Johnlon/integrated-circuit-tester/exploratoryTool.png

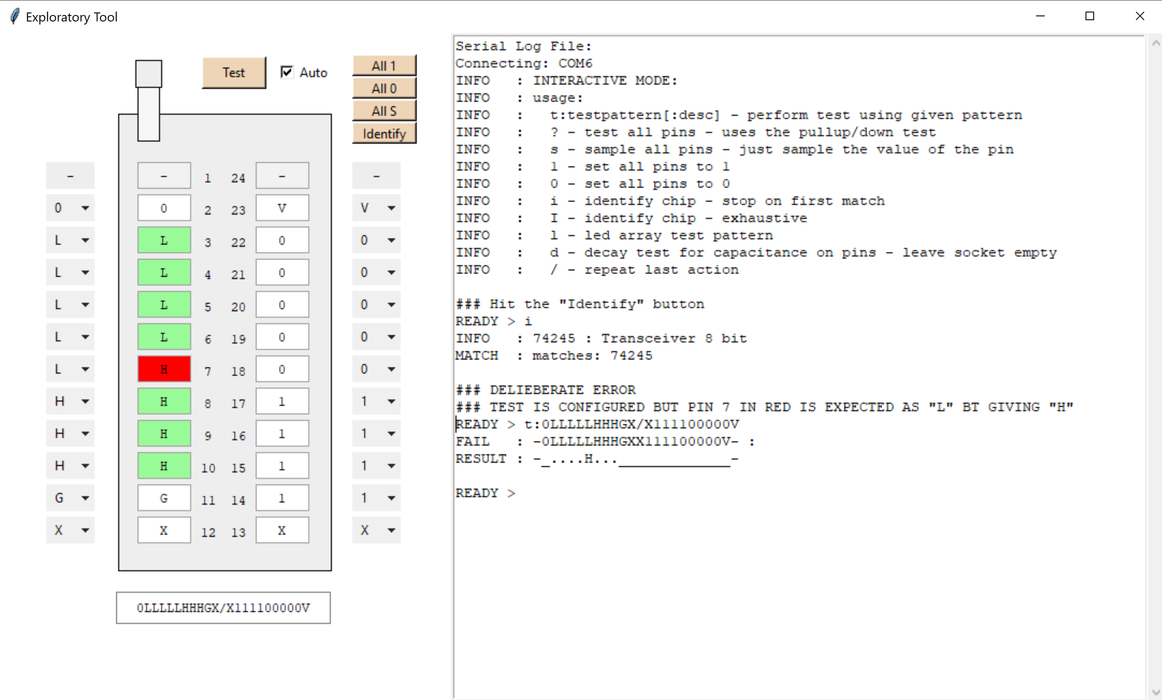
exploratoryTool.png
