Johnlon/integrated-circuit-tester/exploratoryToolDropDown.png

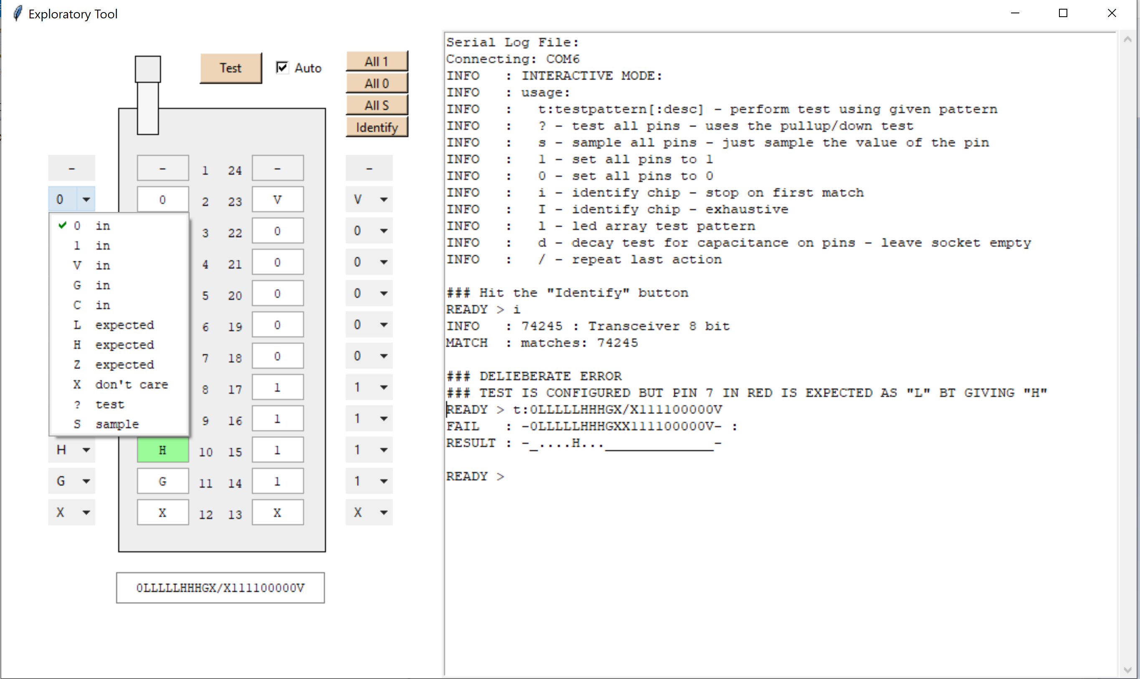
exploratoryToolDropDown.png
