Johnlon/integrated-circuit-tester/thumb1-gui.png

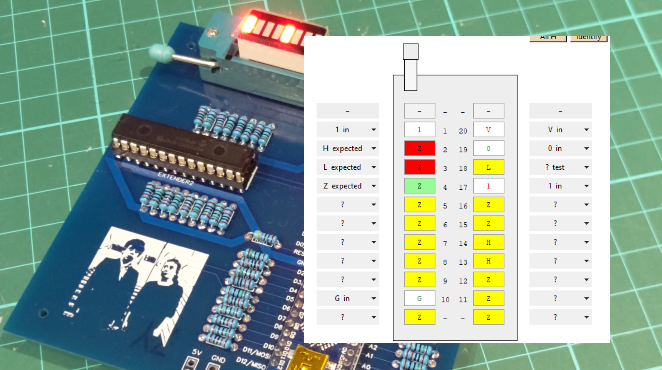
thumb1-gui.png
