Johnlon/integrated-circuit-tester/(threads)

Thread 1 (2021-03-20):

Other ic

saddys, 2021-03-20:
I see you have your own database with a 74245 as well. The smart ic tester can test only 14/16 pin ic's. So does your program test other components too? How do I add a 74374, for example? Or 74240?

Thanks!

Johnlon, 2021-03-22:
Hi additional chips is a matter of adding tests to the file ...
https://github.com/Johnlon/integrated-circuit-tester/blob/master/chipsDatabase.h

The file format is explained in the docs if I recall correctly.

If you are thinking of building one you could use a bigger Arduino with
more pins and avoid extenders or I could send you a PCBs if postage isn't
bad.

John

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

Johnlon, 2021-03-22:
Sorry you meant this file?
The mychipsdatabase.h
Yeah add a pattern to that file and then add the chip to the  list in here
..

https://github.com/Johnlon/integrated-circuit-tester/blob/017f85d0c72f0dbd39f81e58434bf42291b87a08/modeIdentify.ino

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

Johnlon, 2021-03-22:
One of the things I had in mind why I setup the serial terminal was to have
the chip dB in python and just send the tests to the board the same way
exploratory mode works , but I got carried away and wrote the GUI instead
and just left the dB in the Arduino.
Did you look at the hackaday pages as there more detail there and I did
some yt videos on the project.

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
>>> I see you have your own database with a 74245 as well. The smart ic
>>> tester can test only 14/16 pin ic's. So does your program test other
>>> components too? How do I add a 74374, for example? Or 74240?
>>>
>>> Thanks!
>>>
>>> —
>>> You are receiving this because you are subscribed to this thread.
>>> Reply to this email directly, view it on GitHub
>>> <https://github.com/Johnlon/integrated-circuit-tester/issues/1>, or
>>> unsubscribe
>>> <https://github.com/notifications/unsubscribe-auth/AAGMFGD3AAVYLFX6GFNAQCDTEUPFPANCNFSM4ZQ4BRRA>
>>> .
>>>
>>

saddys, 2021-03-22:
Thanks for answer.

I can add pin and modify sketch for test bigger chip, but i cant understand
how make new table in database.txt for other chip (i need 74240 and 74374).
You can gentle help me? Ty

Il lun 22 mar 2021, 04:37 John Lonergan ***@***.***> ha
scritto:

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

Johnlon, 2021-03-22:
Forget database.txt - that is a copy of someone else's tests and only to be
updated by copying their latest list.

---

You need to edit ...
https://github.com/Johnlon/integrated-circuit-tester/blob/017f85d0c72f0dbd39f81e58434bf42291b87a08/myChipsDatabase.h

Full instructions on how to understand the format is given here ...

https://github.com/Johnlon/integrated-circuit-tester/tree/017f85d0c72f0dbd39f81e58434bf42291b87a08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

Have a go first and I'll review a pull request. It's very simple. Read the
doco and tell me what you don't understand

But I can't test your patterns for you for the 240 as I don't have one, but
I might have the flipflop chip.

Thanks for the interest.

John

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

saddys, 2021-03-22:
Are you saying that database.txt is not good?

I understand the pattern code, Thanks for the link. 0/1 is used for input
and H/L/Z are for reading. Theorically with a thrut table of a datasheet I
can made for every chip! But this chip have clock, i have to try and learn
to use the pattern

Ty!

Il lun 22 mar 2021, 13:14 John Lonergan ***@***.***> ha
scritto:

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

Johnlon, 2021-03-23:
I am saying that database. Txt is the wrong file to edit.
Instead edit mychipsdatabae.h

If I recall the C is for clock but I haven't looked at it in ages.

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

Johnlon, 2021-04-03:
Any luck?

Johnlon, 2022-02-22:
Stale conversation

Closed 2022-02-22.

Thread 2 (2023-01-21):

Ideas to simplify the circuit

ole00, 2023-01-21:
Hi,
thanks for sharing your project and for the explanation write-up.

Your design uses 2 MCU pins to drive one TIC (tested IC) pin. I was wondering whether this could be simplified and only one MCU pin could be used (to drive or sense one TIC pin)  for a simpler testing device - basically to test 14-pin-only 74xx logic devices where the VCC and GND are on the fixed position.
* VCC and GND: fixed on specific TIC pins, hardwired on the board
* TIC input: arduino pin set as output with value 0/1 depending on the test case
* TIC output: arduino pin set as input either with or without internal pull-up. Each pin would be also pulled Down externally with very weak resistor (~300k - 500k) so that the internal arduino pull-up (if set) can still drive the pin high (overriding the external pull down). Also the TIC should have no problem to overdrive the external pull-down when it sets the level High. The High Z could also be tested by both enabling internal Pull-Up (and read value from the pin) then disabling the internal pull-up (and read the value from the pin). In the first case the pin should read H and in the second case the pin should read L to verify the TIC pin is really in high Z state. Open collector pin tests should also work (I think) by setting the MCU pin with internal pull-up, which the TIC pin should be able to drive L.
* All data pins would have a 2k2 resistor in series as a protection from damaged TIC pin / logic

Of course such design would be limited to a subset of TIC devices, but could eliminate the external GPIO chips. Basically the device would only consist of the ZIF socket and bunch of resistors. Simple to build on a bread board or protoboard in a few hours.

Any ideas ? Any situations where it would not work, or would not work reliably? Thanks.

Johnlon, 2023-01-22:
Yeah the setup is for driving power and also open circuit.

If you have fixed power then just hard wire that.

I do not think the highz / open circuit detection will work without my design though.

ole00, 2023-01-22:
Thanks for the reply. Your unedited answer nudged me to try that. :)  And it seems to work so far. The test code is like that:

```
            case 'Z':
                {
                    uint16_t x = 0;
                    Serial.print("Test pin: ");
                    Serial.println(pinIndex);
                    while(x++ < 10){
                        pinMode(p, OUTPUT);
                        digitalWrite(p, 0); // force the pin Low
                        delayMicroseconds(20);
                        pinMode(p, INPUT_PULLUP); //weak internal pull up should raise the pin High
                        delayMicroseconds(100);
                        if (digitalRead(p) != 1) { //test the pin is High
                            res++;
                            testResult[i] = 'E';
                        }
                        digitalWrite(p, 1); // force the pin High
                        delayMicroseconds(20);
                        pinMode(p, INPUT); //weak external pull down should set the pin Low
                        delayMicroseconds(100);
                        if (digitalRead(p) != 0) { //test the pin is Low
                            res++;
                            testResult[i] = 'E';
                        }
                    }
                    pinIndex++;
                }
```

I also scoped the pins to give me and idea how it works and it looks good. This was tested on a pin with no IC attached.
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
