Johnlon/integrated-circuit-tester/(commit log)

2020-01-30 added ? and u and fixed some logic - still need to add Z tests to verify that outputs are really 1 or 0
    [get_pin.h, integrated-circuit-tester.ino, test_ic.ino]
2020-01-31 added more docs on capacitance testing
2020-02-01 added more docs on capacitance
2020-02-02 moved extended pin funcs into own file
2020-02-03 added util to generate tests from 3rd party db and also replaced lot of String functions as they were causing memory issues (apparently a well known issue)
    [chipsDatabase.h, convertTxtDatabaseToC.py, integrated-circuit-tester.ino, myChipsDatabase.h, test_ic.ino, tester_wires.ino]
2020-02-05 fixed buf len buf
    [test_ic.ino]
2020-02-07 added S test code and fixed the ?
    [test_ic.ino]
2020-02-12 add full test db back, add more options like 1/0/s/l - then fix the memory footprint
    [io.ino, miscTests.ino, modeIdentify.ino, modeInteractive.ino, myChipsDatabase.h, strings.ino, test_ic.ino]
2020-02-25 reconnect and port selection problem
    [gui.py, reconnect.py, serialMonitor.py]
2020-02-26 reconnect sample added
2020-03-04 options of buttons or drop down menu
